vanvught/EXT-PHY-RTL8201F-POE/README.md

# External PHY RTL8201F with POE

Successfully tested with [https://www.adafruit.com/product/3847](https://www.adafruit.com/product/3847)

More information [https://www.gd32-dmx.org/ethernet.html](https://www.gd32-dmx.org/ethernet.html)
