vanvught/EXT-PHY-RTL8201F-POE/BOM.xlsx

Qty | Designator | Footprint | Comment | LCSC Part #
9 | C1, C2, C4, C5, C6, C7, C8, C10, C11 | C0603 | 100n | C14663
4 | C12, C13, C14, C15 | C0805 | 10nF | C106844
1 | C16 | C0603 | 10uF | C19702
3 | C3, C17, C18 | A/3216-18R | 10uF | C7171
1 | C9 | C1206 | 1nF/2kV | C9196
2 | FL1, FL2 | 603 | MZAS1608G121-1R3TF0603 | C709642
1 | IC1 | QFN50P500X500X100-33N | RTL8201F-VB-CG | C45044
1 | J1 | 34065493 | TE-CONNECTIVITY-2406549 | C125068
2 | LED1, LED2 | CHIP-LED0603 | 3V3 | C2286
1 | Q1 | 3.2X2.5_KXO-V96 | 50MHz | C160451
3 | R1, R4, R14 | R0603 | 1K5 | C22843
1 | R13 | R0603 | 0R | C2889381
1 | R18 | R0603 | 2K49 | C100897
7 | R2, R3, R5, R8, R15, R16, R17 | R0603 | 4K7 | C23162
2 | R6, R7 | R0603 | 510 | C23193
4 | R9, R10, R11, R12 | R0603 | 75 | C228048
2 | RN1, RN2 | 4X0402ARV341 | 33 | C25501
1 | T1 | SOIC127P952X572-16N | H1692CE-A | C2904705
