vanvught/EXT-PHY-RTL8201F-POE/EXT-PHY.brd

## EAGLE design EXT-PHY.brd (2026-03-12)

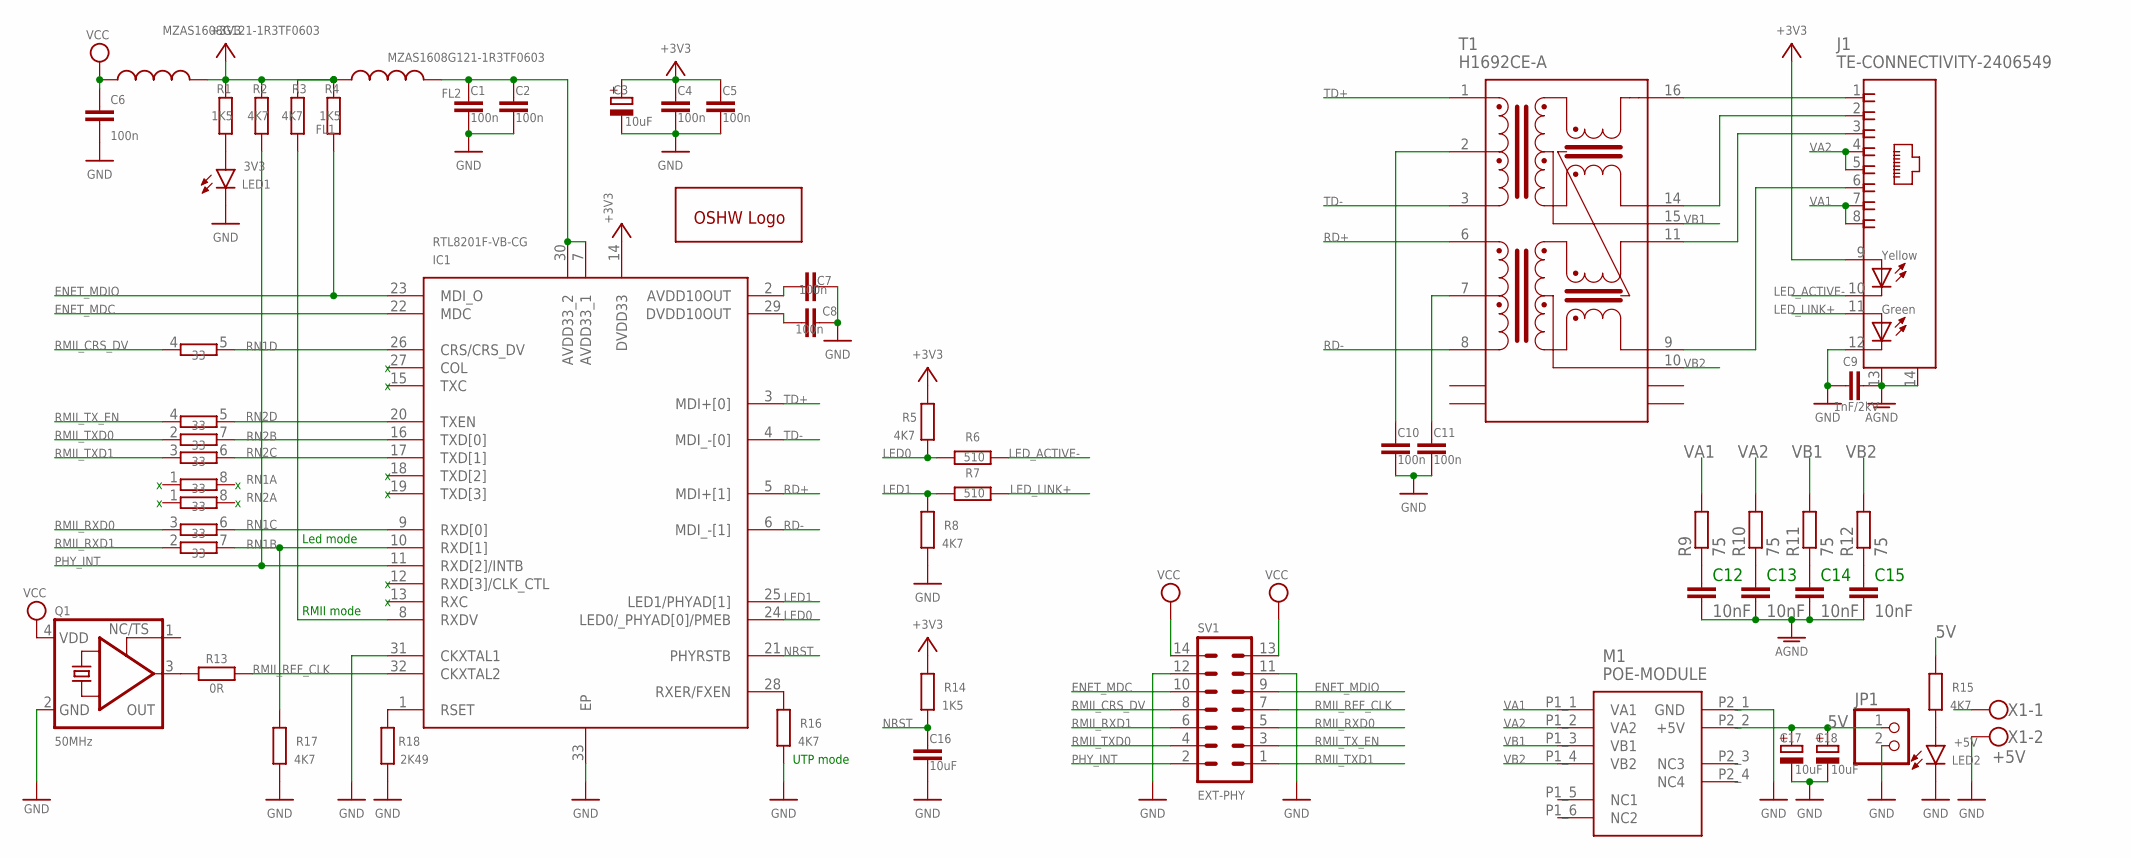
[picture p1: schematic EXT-PHY.sch]

Parts:
C1, C2, C4, C5, C6, C7, C8, C10, C11: 100n; C0603; JLCPCB C14663
C3, C17, C18: 10uF; A/3216-18R; JLCPCB C7171
C9: 1nF/2kV; C1206; JLCPCB C9196
C12, C13, C14, C15: 10nF; C0805; JLCPCB C106844
C16: 10uF; C0603; JLCPCB C19702
FL1, FL2: MZAS1608G121-1R3TF0603; 0603
GOLD_ORB_SM1: OSHWLOGOLOGO5MM; OSHW_5MM
IC1: RTL8201F-VB-CG; QFN50P500X500X100-33N; JLCPCB C45044
J1: TE-CONNECTIVITY-2406549; 34065493
JP1: PINHD-1X2; 1X02
LED1: 3V3; CHIP-LED0603; JLCPCB C72043
LED2: +5V; CHIP-LED0603; JLCPCB C72043
M1: POE-MODULE
Q1: 50MHz; 3.2X2.5_KXO-V96; JLCPCB C160451
R1, R4, R14: 1K5; R0603; JLCPCB C22843
R2, R3, R5, R8, R15, R16, R17: 4K7; R0603; JLCPCB C23162
R6, R7: 510; R0603; JLCPCB C23193
R9, R10, R11, R12: 75; R0603; JLCPCB C228048
R13: 0R; R0603; JLCPCB C115304
R18: 2K49; R0603; JLCPCB C100897
RN1, RN2: 33; 4X0402ARV341; JLCPCB C25501
SV1: EXT-PHY; MA07-2W
T1: H1692CE-A; SOIC127P952X572-16N
X1: +5V; W237-102

Connections:
5V: C17.+, C18.+, JP1.1, M1.P2_2 (+5V), R15.2, X1.1
50MHZ: Q1.3 (OUT), R13.1
+3V3: C3.+, C4.1, C5.1, FL1.2, FL2.1, IC1.14 (DVDD33), J1.9 (+_1), R1.2, R2.2, R3.1, R4.2, R5.2, R14.2
AGND: C9.2, C12.2, C13.2, C14.2, C15.2, J1.13 (S1), J1.14 (S2)
AVDD: C1.1, C2.1, FL2.2, IC1.7 (AVDD33_1), IC1.30 (AVDD33_2)
ENET_MDC: IC1.22 (MDC), SV1.10
ENET_MDIO: IC1.23 (MDI_O), R4.1, SV1.9
GND: C1.2, C2.2, C3.-, C4.2, C5.2, C6.2, C7.2, C8.1, C9.1, C10.2, C11.2, C16.2, C17.-, C18.-, IC1.31 (CKXTAL1), IC1.33 (EP), J1.12 (-_2), JP1.2, LED1.C, LED2.C, M1.P2_1 (GND), Q1.2 (GND), R8.1, R16.1, R17.1, R18.2, SV1.11, SV1.12, X1.2
LED0: IC1.24 (LED0/_PHYAD[0]/PMEB), R5.1, R6.2
LED1: IC1.25 (LED1/PHYAD[1]), R7.2, R8.2
LED_ACTIVE-: J1.10 (-_1), R6.1
LED_LINK+: J1.11 (+_2), R7.1
unnamed: LED1.A, R1.1
unnamed: LED2.A, R15.1
unnamed: C10.1, T1.2
unnamed: IC1.1 (RSET), R18.1
unnamed: IC1.8 (RXDV), R3.2
unnamed: C8.2, IC1.29 (DVDD10OUT)
unnamed: IC1.28 (RXER/FXEN), R16.2
unnamed: J1.1, T1.16
unnamed: C12.1, R9.1
unnamed: C13.1, R10.1
unnamed: C7.1, IC1.2 (AVDD10OUT)
unnamed: J1.2, T1.14
unnamed: J1.3, T1.11
unnamed: J1.6, T1.9
unnamed: C11.1, T1.7
unnamed: C14.1, R11.1
unnamed: C15.1, R12.1
NRST: C16.1, IC1.21 (PHYRSTB), R14.1
PHY_INT: IC1.11 (RXD[2]/INTB), R2.1, SV1.2
RD+: IC1.5 (MDI+[1]), T1.6
RD-: IC1.6 (MDI_-[1]), T1.8
RMII_CRS_DV: RN1.4 (1), SV1.8
RMII_REF_CLK: IC1.32 (CKXTAL2), R13.2, SV1.7
RMII_RXD0: RN1.3 (1), SV1.5
RMII_RXD1: RN1.2 (1), SV1.6
RMII_TXD0: RN2.2 (1), SV1.4
RMII_TXD1: RN2.3 (1), SV1.1
RMII_TX_EN: RN2.4 (1), SV1.3
RXD0: IC1.9 (RXD[0]), RN1.6 (2)
RXD1: IC1.10 (RXD[1]), R17.2, RN1.7 (2)
RXDV: IC1.26 (CRS/CRS_DV), RN1.5 (2)
TD+: IC1.3 (MDI+[0]), T1.1
TD-: IC1.4 (MDI_-[0]), T1.3
TXD0: IC1.16 (TXD[0]), RN2.7 (2)
TXD1: IC1.17 (TXD[1]), RN2.6 (2)
TXEN: IC1.20 (TXEN), RN2.5 (2)
VA1: J1.7, J1.8, M1.P1_1 (VA1), R9.2
VA2: J1.4, J1.5, M1.P1_2 (VA2), R10.2
VB1: M1.P1_3 (VB1), R11.2, T1.15
VB2: M1.P1_4 (VB2), R12.2, T1.10
VCC: C6.1, FL1.1, Q1.4 (VDD), SV1.13, SV1.14

Notes on the sheet:
RMII mode
UTP mode
Led mode

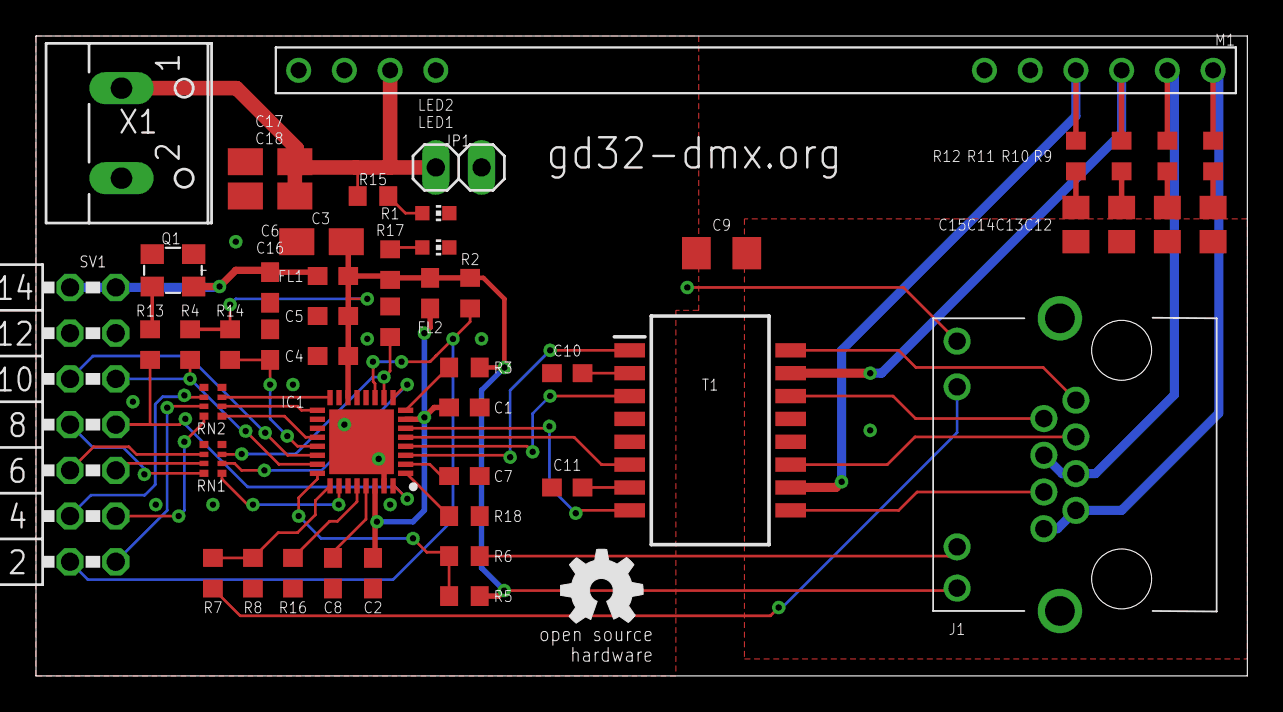
[picture p2: board EXT-PHY.brd from above]

Board: 2 copper layers, 67.3 x 35.6 mm, 51 parts (0 on the bottom side), 53 nets.
